talbertherndon/adaptive-tensile/(commit log)

2026-11-01 Add adaptive tensile stepper control sketch
2026-11-01 Use clean prototype photo from slides as README header
2026-11-02 Add ultrasonic two-flag detection to reverse motor direction
    [adaptive_tensile.ino]
2026-11-02 Add logic flowchart of the sketch
